MonkeyBonkey22/P4T/Images/P4T V1.4.png

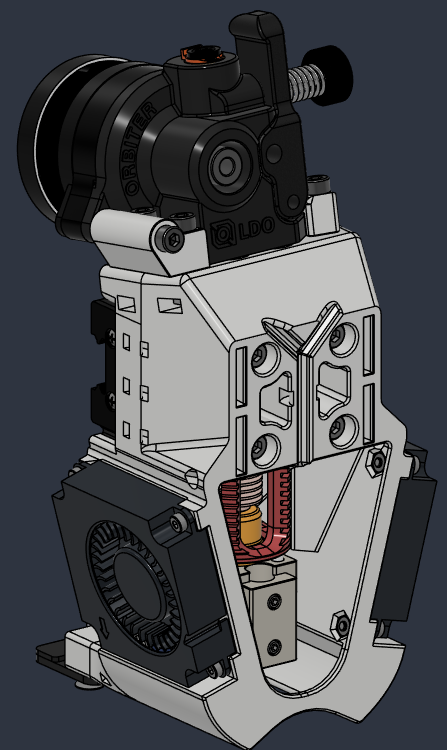
Images/P4T V1.4.png
