MonkeyBonkey22/P4T/CAD/P4T Chube Compact CAD.step

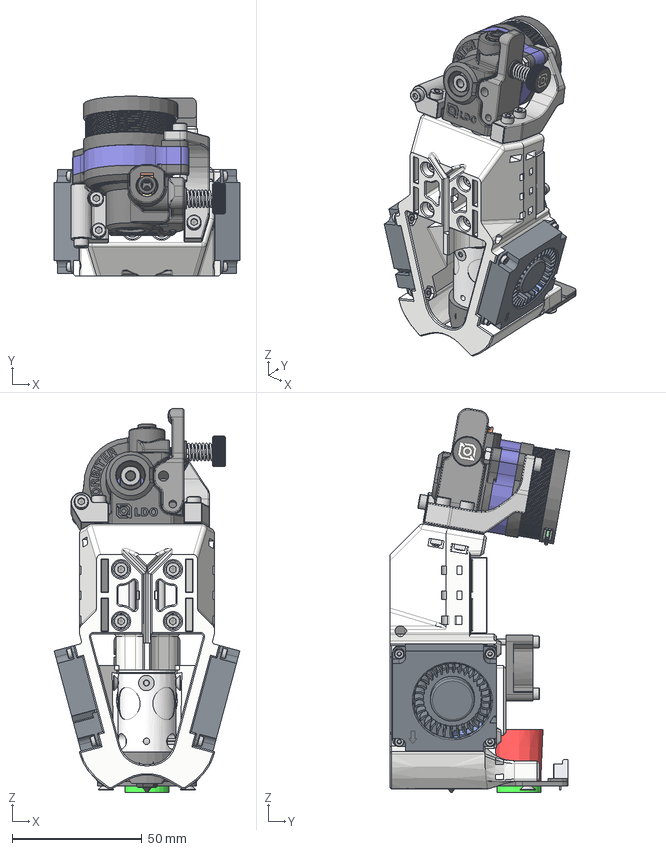
[picture p4: CAD file, 2026-10-09]
CAD/P4T Chube Compact CAD.step
71.6 x 69.2 x 148.0 mm
turbo_fan_40x40x10 x 2
25x25x10_fan
M3x6 FHCS x 2
(Unsaved) x 2
M3x12 SHCS
M2x8 SHCS_1 x 4
DIN 934 - M2 x 0.4 Steel 6 Plain x 4
M2x8 SHCS x 4
DIN 934 - M2 x 0.4 Steel 6 Plain_1 x 4
DIN 562 - M3 Steel 6 Plain x 4
DIN 912 - M2.5 x 0.45 x 16 Steel 4.6 Plain x 4
DIN 912 - M3 x 0.5 x 30 Steel 4.6 Plain x 4
DIN 125 - A 2.7 Steel 100 HV Plain x 4
DIN 912 - M2.5 x 0.45 x 40 Steel 4.6 Plain x 4
DIN 912 - M3 x 0.5 x 16 Steel 4.6 Plain
DIN 912 - M3 x 0.5 x 35 Steel 4.6 Plain
DIN 912 - M3 x 0.5 x 16 Steel 4.6 Plain_1 x 2
DIN 934 - M3 x 0.5 Steel 6 Plain
DIN 912 - M3 x 0.5 x 16 Steel 4.6 Plain_2
DIN 912 - M3 x 0.5 x 20 Steel 4.6 Plain
Fan Insert x 2
Chube_Compact_Integration_Cad
nozzle
Cartridge_rep_3x15mm Cartridge
Cartridge_rep
92125A125_18-8 Stainless Steel Hex Drive Flat Head Screw_92125A125 x 8
