MonkeyBonkey22/P4T/STL/Left Orbiter Brace.stl

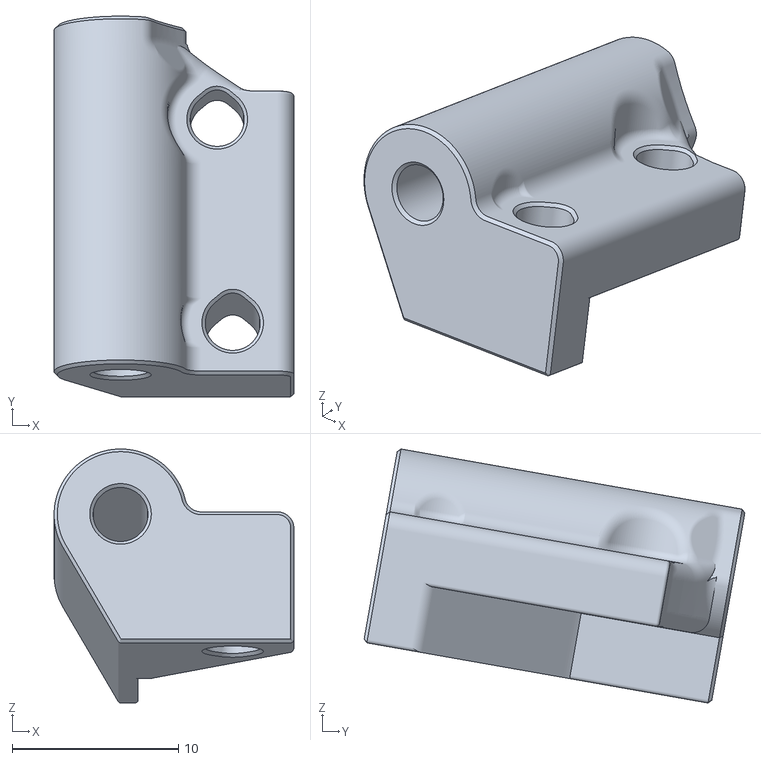
[picture p5: CAD file, 2026-08-26]
STL/Left Orbiter Brace.stl
14.4 x 22.9 x 15.3
