MonkeyBonkey22/P4T/STL/Right Orbiter Brace.stl

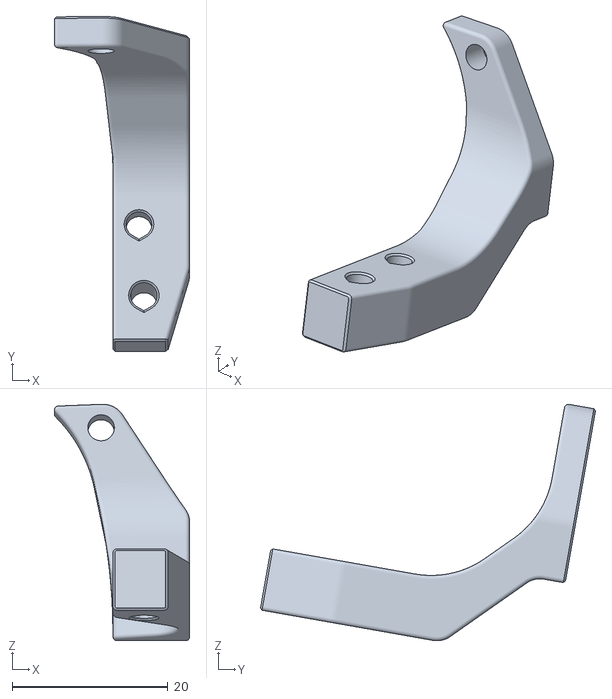
[picture p6: CAD file, 2026-08-26]
STL/Right Orbiter Brace.stl
17.4 x 43.0 x 30.4
