MonkeyBonkey22/P4T/STL/Orbiter2 DAV Monolith P4T.stl

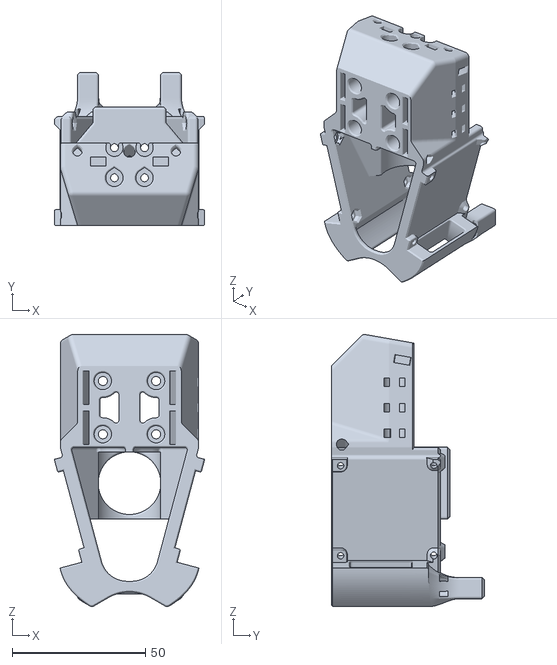
[picture p8: CAD file, 2026-08-11]
STL/Orbiter2 DAV Monolith P4T.stl
56.5 x 57.6 x 102.1
