MonkeyBonkey22/P4T/(list of files, cad)

Other CAD files:
STL/SherpaM DAV Monolith P4T.stl
STL/SherpaM ChubeCompact Monolith P4T.stl
