MonkeyBonkey22/P4T/(commit log)

2026-08-01 cad folder
2026-08-01 Add initial README for STL
2026-08-01 added bom to readme
2026-08-01 Fix formatting in BOM section of README.md
2026-08-01 fix bom format
2026-08-01 Update BOM section format in README
    Reformatted BOM section into a table for better readability.
2026-08-01 Add image to README for P4T toolhead
    Added an image of the P4T toolhead to the README.
2026-08-01 Update current release section formatting in README
2026-08-03 Update README with new fan support feature
    Added support for 4010 fans with A4T fan inserts.
2026-08-06 Update README for release version and supported components
    Updated the current release version from V1.1 to V1.2 and modified the supported extruders and hotends sections.
2026-08-06 uploaded cad and stl files
    [ChubeCompact Orbiter2 Monolith P4T V1.2.stl, ChubeCompact SherpaM Monolith P4T V1.2.stl, DAV Orbiter Monolith P4T V1.2.stl, DAV SherpaM Monolith P4T V1.2.stl]
2026-08-06 Add note on M3x55 screws and washers for Chube Compact
    Added note about required screws and washers for Chube Compact.
2026-08-07 Add installation note for Chube Compact
    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
2026-08-07 updated stls
    [ChubeCompact Orbiter Monolith P4T.stl, ChubeCompact Orbiter2 Monolith P4T V1.2.stl, ChubeCompact SherpaM Monolith P4T V1.2.stl, ChubeCompact SherpaM Monolith P4T.stl, DAV Orbiter Monolith P4T V1.2.stl, DAV Orbiter Monolith P4T.stl, DAV SherpaM Monolith P4T V1.2.stl, DAV SherpaM Monolith P4T.stl]
2026-08-12 Update README for release V1.3 and printing instructions
    Updated the current release version to V1.3, added printing notes, and modified recommendations for Orbiter 2 mounting braces.
2026-08-13 Change current release version to V1.4
    Updated the current release version from V1.3 to V1.4 in the README.
2026-08-13 Update Monolith print settings in README
    Clarified print settings for Monolith in README.
2026-08-13 Update README with weight and material details
    Added weight information and material details for the toolhead.
2026-08-26 new right orbiter brace
    [Left Orbiter Brace.stl, Orbiter 2 Mount Braces.stl, Right Orbiter Brace.stl]
2026-08-26 Revise notes section in README
    Updated notes for hardware recommendations and added advice on using quality screws and drivers.
2026-09-03 Create Chube Compact P4T CAD.step
    [Chube Compact P4T CAD.step]
2026-09-05 fixed compact interference with toolhead
2026-09-07 Chube compact fixed cad 2
    [Chube Compact P4T CAD.step, P4T Chube Compact CAD .step]
2026-09-29 Create P4T SHERPA CAD.step
2026-10-01 cad upd
    [P4T Chube Compact CAD.step]
2026-10-09 +1mm CC thread engangement
2026-10-15 removed voron version
    issue with belt clamps, removed until fixed
2026-10-15 Update README with specific belt support details
    Clarified belt support for Monolith and Voron in features.
